rjopson/RoboAlt/README.md

# RoboAlt
Repository for hardware, firmware, test code for version 1 altimeter
