rjopson/RoboAlt/hardware/README.md

# Hardware

Current hardware:
+ Microcontroller - SAMD21G18A-AUT
+ Voltage Regulator - MIC5219-3.3BM5
+ Flash Memory - AT45DB641E
+ Output MOSFET's - DMN2008LFU
+ Speaker - 
+ Sensors:
  + Barometer, thermometer - MS5607
  + Accelerometer (low g) - MPU-6050
  + Accelerometer (high g) - H3LIS331DL
