rjopson/RoboAlt/hardware/KiCad/README.md

# KiCad Hardware Files

The Hardware folder contains all the KiCad hardware design files:
+ .pro is the project file - KiCad opens this
+ .sch is the schematic file
+ .kicad_pcb is the pcb board file. 
+ componentLibraries folder contains all the schematic and footprint components for the schematic and board files
