rjopson/RoboAlt/hardware/KiCad/BOM.xlsx

Sheet: Sheet1
version | source | date | tool | number | name | tstamps | title | company | rev | date2 | source3 | number4 | value | ref | value5 | footprint | lib | part | names | tstamps6 | tstamp | lib7 | part8 | field | name9 | num | name10 | type | description | fp | docs | logical | uri | code | name11 | ref12 | pin
D | C:/Users/Jim/Documents/Rockets/Altimeters/RoboDev/Hardware/KiCad/altimeter.sch | 7/25/2019 11:19:43 AM | Eeschema 4.0.4-stable | 1 | / | / | RoboAlt v0.1 |  | v0.1 | 2019-02-10 | altimeter.sch | 1
D | C:/Users/Jim/Documents/Rockets/Altimeters/RoboDev/Hardware/KiCad/altimeter.sch | 7/25/2019 11:19:43 AM | Eeschema 4.0.4-stable | 1 | / | / | RoboAlt v0.1 |  | v0.1 | 2019-02-10 | altimeter.sch | 2
D | C:/Users/Jim/Documents/Rockets/Altimeters/RoboDev/Hardware/KiCad/altimeter.sch | 7/25/2019 11:19:43 AM | Eeschema 4.0.4-stable | 1 | / | / | RoboAlt v0.1 |  | v0.1 | 2019-02-10 | altimeter.sch | 3
D | C:/Users/Jim/Documents/Rockets/Altimeters/RoboDev/Hardware/KiCad/altimeter.sch | 7/25/2019 11:19:43 AM | Eeschema 4.0.4-stable | 1 | / | / | RoboAlt v0.1 |  | v0.1 | 2019-02-10 | altimeter.sch | 4
D |  |  |  |  |  |  |  |  |  |  |  |  |  | U1 | SAMD21G18A-AUT | altimeterComponentFootprints:TQFP-48_7x7mm_Pitch0.5mm | altimeterComponentSchematics | SAMD21G18A-AUT | / | / | 5C610ED9
D |  |  |  |  |  |  |  |  |  |  |  |  |  | SP1 | SPEAKER | altimeterComponentFootprints:BUZZER_CCV | device | SPEAKER | / | / | 5C611002
D |  |  |  |  |  |  |  |  |  |  |  |  |  | U2 | MIC5219-3.3BM5 | altimeterComponentFootprints:SOT23_5 | altimeterComponentSchematics | MIC5219-3.3BM5 | / | / | 5C6110C4
D |  |  |  |  |  |  |  |  |  |  |  |  |  | C6 | 100mF | altimeterComponentFootprints:PB-5R0H104-R_Super_Capacitor_horizontal | device | CP | / | / | 5C61111F
D |  |  |  |  |  |  |  |  |  |  |  |  |  | U3 | MICRO-B_USB | altimeterComponentFootprints:USB-MICROB | altimeterComponentSchematics | MICRO-B_USB | / | / | 5C6111C9
D |  |  |  |  |  |  |  |  |  |  |  |  |  | U4 | H3LIS331DL | altimeterComponentFootprints:TFLGA-16 | altimeterComponentSchematics | H3LIS331DL | / | / | 5C611232
D |  |  |  |  |  |  |  |  |  |  |  |  |  | U6 | MS5607-02BA03 | altimeterComponentFootprints:QFN8_5x3mm | altimeterComponentSchematics | MS5607-02BA03 | / | / | 5C611291
D |  |  |  |  |  |  |  |  |  |  |  |  |  | U5 | MPU-6050 | altimeterComponentFootprints:QFN_24 | altimeterComponentSchematics | MPU-6050 | / | / | 5C6112D4
D |  |  |  |  |  |  |  |  |  |  |  |  |  | U7 | AT45DB641E | altimeterComponentFootprints:SO08_EIAJ | altimeterComponentSchematics | AT45DB641E | / | / | 5C61132F
D |  |  |  |  |  |  |  |  |  |  |  |  |  | SW1 | SPST | altimeterComponentFootprints:SWITCH_TACTILE_SPST | device | SPST | / | / | 5C611400
D |  |  |  |  |  |  |  |  |  |  |  |  |  | P1 | CONN_01X04 | altimeterComponentFootprints:SCREWTERMINAL_2.54mm_4 | conn | CONN_01X04 | / | / | 5C611553
D |  |  |  |  |  |  |  |  |  |  |  |  |  | P3 | CONN_01X01 | altimeterComponentFootprints:1pin | conn | CONN_01X01 | / | / | 5C61161C
D |  |  |  |  |  |  |  |  |  |  |  |  |  | P4 | CONN_01X01 | altimeterComponentFootprints:1pin | conn | CONN_01X01 | / | / | 5C611719
D |  |  |  |  |  |  |  |  |  |  |  |  |  | Q1 | DMN2008LFU | altimeterComponentFootprints:6-UFDFN_Exposed_Pad | altimeterComponentSchematics | DMN2008LFU | / | / | 5C6A396D
D |  |  |  |  |  |  |  |  |  |  |  |  |  | Q3 | DMN2008LFU | altimeterComponentFootprints:6-UFDFN_Exposed_Pad | altimeterComponentSchematics | DMN2008LFU | / | / | 5C6A4A38
D |  |  |  |  |  |  |  |  |  |  |  |  |  | Q4 | DMN2008LFU | altimeterComponentFootprints:6-UFDFN_Exposed_Pad | altimeterComponentSchematics | DMN2008LFU | / | / | 5C6A5DCD
D |  |  |  |  |  |  |  |  |  |  |  |  |  | P2 | CONN_01X04 | altimeterComponentFootprints:SCREWTERMINAL_2.54mm_4 | conn | CONN_01X04 | / | / | 5C6A6059
D |  |  |  |  |  |  |  |  |  |  |  |  |  | C9 | 2.2uF | altimeterComponentFootprints:C_0603 | device | C | / | / | 5C6A826D
D |  |  |  |  |  |  |  |  |  |  |  |  |  | D2 | LED | altimeterComponentFootprints:LED_0603 | device | LED | / | / | 5C6A82DE
D |  |  |  |  |  |  |  |  |  |  |  |  |  | R5 | 10 | altimeterComponentFootprints:R_1206 | device | R | / | / | 5C6A84CD
D |  |  |  |  |  |  |  |  |  |  |  |  |  | R6 | 4.7k | altimeterComponentFootprints:R_array_4x_1206 | altimeterComponentSchematics | R_4 | / | / | 5C6A8562
D |  |  |  |  |  |  |  |  |  |  |  |  |  | C11 | 10nF | altimeterComponentFootprints:C_0603 | device | C | / | / | 5C735557
D |  |  |  |  |  |  |  |  |  |  |  |  |  | C12 | 0.1uF | altimeterComponentFootprints:C_0603 | device | C | / | / | 5C735616
D |  |  |  |  |  |  |  |  |  |  |  |  |  | C15 | 0.1uF | altimeterComponentFootprints:C_0603 | device | C | / | / | 5C7356B4
D |  |  |  |  |  |  |  |  |  |  |  |  |  | C14 | 2.2nF | altimeterComponentFootprints:C_0603 | device | C | / | / | 5C73576D
D |  |  |  |  |  |  |  |  |  |  |  |  |  | C17 | 0.1uF | altimeterComponentFootprints:C_0603 | device | C | / | / | 5C73BE40
D |  |  |  |  |  |  |  |  |  |  |  |  |  | C16 | 10uF | altimeterComponentFootprints:C_0603 | device | C | / | / | 5C73BF1B
D |  |  |  |  |  |  |  |  |  |  |  |  |  | C13 | 0.1uF | altimeterComponentFootprints:C_0603 | device | C | / | / | 5C741175
D |  |  |  |  |  |  |  |  |  |  |  |  |  | Y1 | 32.768kHz | altimeterComponentFootprints:32khz_crystal | device | Crystal | / | / | 5C74A102
D |  |  |  |  |  |  |  |  |  |  |  |  |  | C3 | 12.5pF | altimeterComponentFootprints:C_array_2x_0805 | altimeterComponentSchematics | C_2 | / | / | 5C74A676
D |  |  |  |  |  |  |  |  |  |  |  |  |  | L1 | 10uH | altimeterComponentFootprints:C_0603 | altimeterComponentSchematics | L | / | / | 5C74BEBE
D |  |  |  |  |  |  |  |  |  |  |  |  |  | C4 | 0.1uF | altimeterComponentFootprints:C_0603 | device | C | / | / | 5C74C95B
D |  |  |  |  |  |  |  |  |  |  |  |  |  | C2 | 0.1uF | altimeterComponentFootprints:C_0603 | device | C | / | / | 5C7522E1
D |  |  |  |  |  |  |  |  |  |  |  |  |  | C8 | 0.1uF | altimeterComponentFootprints:C_0603 | device | C | / | / | 5C75AC96
D |  |  |  |  |  |  |  |  |  |  |  |  |  | C7 | 0.1uF | altimeterComponentFootprints:C_0603 | device | C | / | / | 5C75D376
D |  |  |  |  |  |  |  |  |  |  |  |  |  | C10 | 1uF | altimeterComponentFootprints:C_0603 | device | C | / | / | 5C75D432
D |  |  |  |  |  |  |  |  |  |  |  |  |  | C1 | 10uF | altimeterComponentFootprints:C_array_2x_0805 | altimeterComponentSchematics | C_2 | / | / | 5C75EA86
D |  |  |  |  |  |  |  |  |  |  |  |  |  | R4 | 330 | altimeterComponentFootprints:R_0603 | device | R | / | / | 5C762C04
D |  |  |  |  |  |  |  |  |  |  |  |  |  | C5 | 100pF | altimeterComponentFootprints:C_0603 | device | C | / | / | 5C762FD7
D |  |  |  |  |  |  |  |  |  |  |  |  |  | R3 | 27k | altimeterComponentFootprints:R_array_4x_1206 | altimeterComponentSchematics | R_4 | / | / | 5C769238
D |  |  |  |  |  |  |  |  |  |  |  |  |  | R2 | 100k | altimeterComponentFootprints:R_array_4x_1206 | altimeterComponentSchematics | R_4 | / | / | 5C76F35F
D |  |  |  |  |  |  |  |  |  |  |  |  |  | Q2 | DMN2008LFU | altimeterComponentFootprints:6-UFDFN_Exposed_Pad | altimeterComponentSchematics | DMN2008LFU | / | / | 5C778F61
D |  |  |  |  |  |  |  |  |  |  |  |  |  | R1 | 10k | altimeterComponentFootprints:R_array_4x_1206 | altimeterComponentSchematics | R_4 | / | / | 5C77A1B0
D |  |  |  |  |  |  |  |  |  |  |  |  |  | D1 | Schottky_3 | altimeterComponentFootprints:SOT363 | altimeterComponentSchematics | Schottky_3 | / | / | 5C78129E
D |  |  |  |  |  |  |  |  |  |  |  |  |  |  |  |  |  |  |  |  |  | altimeterComponentSchematics | AT45DB641E | U | Reference
D |  |  |  |  |  |  |  |  |  |  |  |  |  |  |  |  |  |  |  |  |  | altimeterComponentSchematics | AT45DB641E | AT45DB641E | Value
D |  |  |  |  |  |  |  |  |  |  |  |  |  |  |  |  |  |  |  |  |  | altimeterComponentSchematics | AT45DB641E |  |  | 1 | SI | passive
D |  |  |  |  |  |  |  |  |  |  |  |  |  |  |  |  |  |  |  |  |  | altimeterComponentSchematics | AT45DB641E |  |  | 2 | SCK | passive
D |  |  |  |  |  |  |  |  |  |  |  |  |  |  |  |  |  |  |  |  |  | altimeterComponentSchematics | AT45DB641E |  |  | 3 | RESET | passive
D |  |  |  |  |  |  |  |  |  |  |  |  |  |  |  |  |  |  |  |  |  | altimeterComponentSchematics | AT45DB641E |  |  | 4 | CS | passive
D |  |  |  |  |  |  |  |  |  |  |  |  |  |  |  |  |  |  |  |  |  | altimeterComponentSchematics | AT45DB641E |  |  | 5 | WP | passive
D |  |  |  |  |  |  |  |  |  |  |  |  |  |  |  |  |  |  |  |  |  | altimeterComponentSchematics | AT45DB641E |  |  | 6 | VCC | passive
D |  |  |  |  |  |  |  |  |  |  |  |  |  |  |  |  |  |  |  |  |  | altimeterComponentSchematics | AT45DB641E |  |  | 7 | GND | passive
D |  |  |  |  |  |  |  |  |  |  |  |  |  |  |  |  |  |  |  |  |  | altimeterComponentSchematics | AT45DB641E |  |  | 8 | SO | passive
D |  |  |  |  |  |  |  |  |  |  |  |  |  |  |  |  |  |  |  |  |  | device | C | C | Reference |  |  |  | Unpolarized capacitor
D |  |  |  |  |  |  |  |  |  |  |  |  |  |  |  |  |  |  |  |  |  | device | C | C | Value |  |  |  | Unpolarized capacitor
D |  |  |  |  |  |  |  |  |  |  |  |  |  |  |  |  |  |  |  |  |  | device | C |  |  | 1 | ~ | passive | Unpolarized capacitor
D |  |  |  |  |  |  |  |  |  |  |  |  |  |  |  |  |  |  |  |  |  | device | C |  |  | 2 | ~ | passive | Unpolarized capacitor
D |  |  |  |  |  |  |  |  |  |  |  |  |  |  |  |  |  |  |  |  |  | device | C |  |  |  |  |  | Unpolarized capacitor | C?
D |  |  |  |  |  |  |  |  |  |  |  |  |  |  |  |  |  |  |  |  |  | device | C |  |  |  |  |  | Unpolarized capacitor | C_????_*
D |  |  |  |  |  |  |  |  |  |  |  |  |  |  |  |  |  |  |  |  |  | device | C |  |  |  |  |  | Unpolarized capacitor | C_????
D |  |  |  |  |  |  |  |  |  |  |  |  |  |  |  |  |  |  |  |  |  | device | C |  |  |  |  |  | Unpolarized capacitor | SMD*_c
D |  |  |  |  |  |  |  |  |  |  |  |  |  |  |  |  |  |  |  |  |  | device | C |  |  |  |  |  | Unpolarized capacitor | Capacitor*
D |  |  |  |  |  |  |  |  |  |  |  |  |  |  |  |  |  |  |  |  |  | conn | CONN_01X01 | P | Reference |  |  |  | Connector, single row, 01x01
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
D |  |  |  |  |  |  |  |  |  |  |  |  |  |  |  |  |  |  |  |  |  | altimeterComponentSchematics | C_2 |  |  | 2 | ~ | passive
D |  |  |  |  |  |  |  |  |  |  |  |  |  |  |  |  |  |  |  |  |  | altimeterComponentSchematics | C_2 |  |  | 3 | ~ | passive
D |  |  |  |  |  |  |  |  |  |  |  |  |  |  |  |  |  |  |  |  |  | altimeterComponentSchematics | C_2 |  |  | 4 | ~ | passive
D |  |  |  |  |  |  |  |  |  |  |  |  |  |  |  |  |  |  |  |  |  | altimeterComponentSchematics | C_2 |  |  |  |  |  |  | C?
D |  |  |  |  |  |  |  |  |  |  |  |  |  |  |  |  |  |  |  |  |  | altimeterComponentSchematics | C_2 |  |  |  |  |  |  | C_????_*
D |  |  |  |  |  |  |  |  |  |  |  |  |  |  |  |  |  |  |  |  |  | altimeterComponentSchematics | C_2 |  |  |  |  |  |  | C_????
D |  |  |  |  |  |  |  |  |  |  |  |  |  |  |  |  |  |  |  |  |  | altimeterComponentSchematics | C_2 |  |  |  |  |  |  | SMD*_c
D |  |  |  |  |  |  |  |  |  |  |  |  |  |  |  |  |  |  |  |  |  | altimeterComponentSchematics | C_2 |  |  |  |  |  |  | Capacitor*
D |  |  |  |  |  |  |  |  |  |  |  |  |  |  |  |  |  |  |  |  |  | device | Crystal | Y | Reference |  |  |  | Two pin crystal
D |  |  |  |  |  |  |  |  |  |  |  |  |  |  |  |  |  |  |  |  |  | device | Crystal | Crystal | Value |  |  |  | Two pin crystal
D |  |  |  |  |  |  |  |  |  |  |  |  |  |  |  |  |  |  |  |  |  | device | Crystal |  |  | 1 | 1 | passive | Two pin crystal
D |  |  |  |  |  |  |  |  |  |  |  |  |  |  |  |  |  |  |  |  |  | device | Crystal |  |  | 2 | 2 | passive | Two pin crystal
D |  |  |  |  |  |  |  |  |  |  |  |  |  |  |  |  |  |  |  |  |  | device | Crystal |  |  |  |  |  | Two pin crystal | Crystal_*
D |  |  |  |  |  |  |  |  |  |  |  |  |  |  |  |  |  |  |  |  |  | altimeterComponentSchematics | DMN2008LFU | Q | Reference |  |  |  | 60V Vds 0.5A Id, N-Channel MOSFET, SOT-23 |  | http://www.fairchildsemi.com/ds/BS/BS170.pdf
D |  |  |  |  |  |  |  |  |  |  |  |  |  |  |  |  |  |  |  |  |  | altimeterComponentSchematics | DMN2008LFU | DMN2008LFU | Value |  |  |  | 60V Vds 0.5A Id, N-Channel MOSFET, SOT-23 |  | http://www.fairchildsemi.com/ds/BS/BS170.pdf
D |  |  |  |  |  |  |  |  |  |  |  |  |  |  |  |  |  |  |  |  |  | altimeterComponentSchematics | DMN2008LFU | 4 pin | Footprint |  |  |  | 60V Vds 0.5A Id, N-Channel MOSFET, SOT-23 |  | http://www.fairchildsemi.com/ds/BS/BS170.pdf
D |  |  |  |  |  |  |  |  |  |  |  |  |  |  |  |  |  |  |  |  |  | altimeterComponentSchematics | DMN2008LFU |  |  | 1 | G | input | 60V Vds 0.5A Id, N-Channel MOSFET, SOT-23 |  | http://www.fairchildsemi.com/ds/BS/BS170.pdf
D |  |  |  |  |  |  |  |  |  |  |  |  |  |  |  |  |  |  |  |  |  | altimeterComponentSchematics | DMN2008LFU |  |  | 2 | S | passive | 60V Vds 0.5A Id, N-Channel MOSFET, SOT-23 |  | http://www.fairchildsemi.com/ds/BS/BS170.pdf
D |  |  |  |  |  |  |  |  |  |  |  |  |  |  |  |  |  |  |  |  |  | altimeterComponentSchematics | DMN2008LFU |  |  | 3 | D | passive | 60V Vds 0.5A Id, N-Channel MOSFET, SOT-23 |  | http://www.fairchildsemi.com/ds/BS/BS170.pdf
D |  |  |  |  |  |  |  |  |  |  |  |  |  |  |  |  |  |  |  |  |  | altimeterComponentSchematics | DMN2008LFU |  |  |  |  |  | 60V Vds 0.5A Id, N-Channel MOSFET, SOT-23 | SOT-23* | http://www.fairchildsemi.com/ds/BS/BS170.pdf
D |  |  |  |  |  |  |  |  |  |  |  |  |  |  |  |  |  |  |  |  |  | altimeterComponentSchematics | H3LIS331DL | U | Reference
D |  |  |  |  |  |  |  |  |  |  |  |  |  |  |  |  |  |  |  |  |  | altimeterComponentSchematics | H3LIS331DL | H3LIS331DL | Value
D |  |  |  |  |  |  |  |  |  |  |  |  |  |  |  |  |  |  |  |  |  | altimeterComponentSchematics | H3LIS331DL |  |  | 1 | VDD_IO | passive
D |  |  |  |  |  |  |  |  |  |  |  |  |  |  |  |  |  |  |  |  |  | altimeterComponentSchematics | H3LIS331DL |  |  | 2 | NC | passive
D |  |  |  |  |  |  |  |  |  |  |  |  |  |  |  |  |  |  |  |  |  | altimeterComponentSchematics | H3LIS331DL |  |  | 3 | NC | passive
D |  |  |  |  |  |  |  |  |  |  |  |  |  |  |  |  |  |  |  |  |  | altimeterComponentSchematics | H3LIS331DL |  |  | 4 | SCL/SPC | passive
D |  |  |  |  |  |  |  |  |  |  |  |  |  |  |  |  |  |  |  |  |  | altimeterComponentSchematics | H3LIS331DL |  |  | 5 | GND | passive
D |  |  |  |  |  |  |  |  |  |  |  |  |  |  |  |  |  |  |  |  |  | altimeterComponentSchematics | H3LIS331DL |  |  | 6 | SDA/SDI/SDO | passive
D |  |  |  |  |  |  |  |  |  |  |  |  |  |  |  |  |  |  |  |  |  | altimeterComponentSchematics | H3LIS331DL |  |  | 7 | SDO/SDA0 | passive
D |  |  |  |  |  |  |  |  |  |  |  |  |  |  |  |  |  |  |  |  |  | altimeterComponentSchematics | H3LIS331DL |  |  | 8 | CS | passive
D |  |  |  |  |  |  |  |  |  |  |  |  |  |  |  |  |  |  |  |  |  | altimeterComponentSchematics | H3LIS331DL |  |  | 9 | INT2 | passive
D |  |  |  |  |  |  |  |  |  |  |  |  |  |  |  |  |  |  |  |  |  | altimeterComponentSchematics | H3LIS331DL |  |  | 10 | RESERVED | passive
D |  |  |  |  |  |  |  |  |  |  |  |  |  |  |  |  |  |  |  |  |  | altimeterComponentSchematics | H3LIS331DL |  |  | 11 | INT1 | passive
D |  |  |  |  |  |  |  |  |  |  |  |  |  |  |  |  |  |  |  |  |  | altimeterComponentSchematics | H3LIS331DL |  |  | 12 | GND | passive
D |  |  |  |  |  |  |  |  |  |  |  |  |  |  |  |  |  |  |  |  |  | altimeterComponentSchematics | H3LIS331DL |  |  | 13 | GND | passive
D |  |  |  |  |  |  |  |  |  |  |  |  |  |  |  |  |  |  |  |  |  | altimeterComponentSchematics | H3LIS331DL |  |  | 14 | VDD | passive
D |  |  |  |  |  |  |  |  |  |  |  |  |  |  |  |  |  |  |  |  |  | altimeterComponentSchematics | H3LIS331DL |  |  | 15 | RESERVED | passive
D |  |  |  |  |  |  |  |  |  |  |  |  |  |  |  |  |  |  |  |  |  | altimeterComponentSchematics | H3LIS331DL |  |  | 16 | GND | passive
D |  |  |  |  |  |  |  |  |  |  |  |  |  |  |  |  |  |  |  |  |  | altimeterComponentSchematics | L | L | Reference |  |  |  | Inductor
D |  |  |  |  |  |  |  |  |  |  |  |  |  |  |  |  |  |  |  |  |  | altimeterComponentSchematics | L | L | Value |  |  |  | Inductor
D |  |  |  |  |  |  |  |  |  |  |  |  |  |  |  |  |  |  |  |  |  | altimeterComponentSchematics | L |  |  | 1 | ~ | passive | Inductor
D |  |  |  |  |  |  |  |  |  |  |  |  |  |  |  |  |  |  |  |  |  | altimeterComponentSchematics | L |  |  | 2 | ~ | passive | Inductor
D |  |  |  |  |  |  |  |  |  |  |  |  |  |  |  |  |  |  |  |  |  | altimeterComponentSchematics | L |  |  |  |  |  | Inductor | Choke_*
D |  |  |  |  |  |  |  |  |  |  |  |  |  |  |  |  |  |  |  |  |  | altimeterComponentSchematics | L |  |  |  |  |  | Inductor | *Coil*
D |  |  |  |  |  |  |  |  |  |  |  |  |  |  |  |  |  |  |  |  |  | device | LED | D | Reference
D |  |  |  |  |  |  |  |  |  |  |  |  |  |  |  |  |  |  |  |  |  | device | LED | LED | Value
D |  |  |  |  |  |  |  |  |  |  |  |  |  |  |  |  |  |  |  |  |  | device | LED |  |  | 1 | K | passive
D |  |  |  |  |  |  |  |  |  |  |  |  |  |  |  |  |  |  |  |  |  | device | LED |  |  | 2 | A | passive
D |  |  |  |  |  |  |  |  |  |  |  |  |  |  |  |  |  |  |  |  |  | device | LED |  |  |  |  |  |  | LED-*
D |  |  |  |  |  |  |  |  |  |  |  |  |  |  |  |  |  |  |  |  |  | device | LED |  |  |  |  |  |  | LED_*
D |  |  |  |  |  |  |  |  |  |  |  |  |  |  |  |  |  |  |  |  |  | altimeterComponentSchematics | MIC5219-3.3BM5 | U | Reference
D |  |  |  |  |  |  |  |  |  |  |  |  |  |  |  |  |  |  |  |  |  | altimeterComponentSchematics | MIC5219-3.3BM5 | MIC5219-3.3BM5 | Value
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
D |  |  |  |  |  |  |  |  |  |  |  |  |  |  |  |  |  |  |  |  |  | altimeterComponentSchematics | SAMD21G18A-AUT |  |  | 46 | PA31/EIC/SCOM1PAD3/TC | input
D |  |  |  |  |  |  |  |  |  |  |  |  |  |  |  |  |  |  |  |  |  | altimeterComponentSchematics | SAMD21G18A-AUT |  |  | 47 | PB02/EIC/AIN10/SCOM5PAD0 | input
D |  |  |  |  |  |  |  |  |  |  |  |  |  |  |  |  |  |  |  |  |  | altimeterComponentSchematics | SAMD21G18A-AUT |  |  | 48 | PB03/EIC/AIN11/SCOM5PAD1 | input
D |  |  |  |  |  |  |  |  |  |  |  |  |  |  |  |  |  |  |  |  |  | device | SPEAKER | SP | Reference |  |  |  | Audio speaker, 2 pins, generic symbol
D |  |  |  |  |  |  |  |  |  |  |  |  |  |  |  |  |  |  |  |  |  | device | SPEAKER | SPEAKER | Value |  |  |  | Audio speaker, 2 pins, generic symbol
D |  |  |  |  |  |  |  |  |  |  |  |  |  |  |  |  |  |  |  |  |  | device | SPEAKER |  |  | 1 | 1 | input | Audio speaker, 2 pins, generic symbol
D |  |  |  |  |  |  |  |  |  |  |  |  |  |  |  |  |  |  |  |  |  | device | SPEAKER |  |  | 2 | 2 | input | Audio speaker, 2 pins, generic symbol
D |  |  |  |  |  |  |  |  |  |  |  |  |  |  |  |  |  |  |  |  |  | device | SPST | SW | Reference |  |  |  | Interrupteur simple
D |  |  |  |  |  |  |  |  |  |  |  |  |  |  |  |  |  |  |  |  |  | device | SPST | SPST | Value |  |  |  | Interrupteur simple
D |  |  |  |  |  |  |  |  |  |  |  |  |  |  |  |  |  |  |  |  |  | device | SPST |  |  | 1 | 1 | input | Interrupteur simple
D |  |  |  |  |  |  |  |  |  |  |  |  |  |  |  |  |  |  |  |  |  | device | SPST |  |  | 2 | 2 | input | Interrupteur simple
D |  |  |  |  |  |  |  |  |  |  |  |  |  |  |  |  |  |  |  |  |  | altimeterComponentSchematics | Schottky_3 | D | Reference
D |  |  |  |  |  |  |  |  |  |  |  |  |  |  |  |  |  |  |  |  |  | altimeterComponentSchematics | Schottky_3 | Schottky_3 | Value
D |  |  |  |  |  |  |  |  |  |  |  |  |  |  |  |  |  |  |  |  |  | altimeterComponentSchematics | Schottky_3 |  |  | 1 | K | passive
D |  |  |  |  |  |  |  |  |  |  |  |  |  |  |  |  |  |  |  |  |  | altimeterComponentSchematics | Schottky_3 |  |  | 2 | A | passive
D |  |  |  |  |  |  |  |  |  |  |  |  |  |  |  |  |  |  |  |  |  | altimeterComponentSchematics | Schottky_3 |  |  | 3 | K | passive
D |  |  |  |  |  |  |  |  |  |  |  |  |  |  |  |  |  |  |  |  |  | altimeterComponentSchematics | Schottky_3 |  |  | 4 | A | passive
D |  |  |  |  |  |  |  |  |  |  |  |  |  |  |  |  |  |  |  |  |  | altimeterComponentSchematics | Schottky_3 |  |  | 5 | K | passive
D |  |  |  |  |  |  |  |  |  |  |  |  |  |  |  |  |  |  |  |  |  | altimeterComponentSchematics | Schottky_3 |  |  | 6 | A | passive
D |  |  |  |  |  |  |  |  |  |  |  |  |  |  |  |  |  |  |  |  |  | altimeterComponentSchematics | Schottky_3 |  |  |  |  |  |  | D-Pak_TO252AA
D |  |  |  |  |  |  |  |  |  |  |  |  |  |  |  |  |  |  |  |  |  | altimeterComponentSchematics | Schottky_3 |  |  |  |  |  |  | Diode_*
D |  |  |  |  |  |  |  |  |  |  |  |  |  |  |  |  |  |  |  |  |  | altimeterComponentSchematics | Schottky_3 |  |  |  |  |  |  | *SingleDiode
D |  |  |  |  |  |  |  |  |  |  |  |  |  |  |  |  |  |  |  |  |  | altimeterComponentSchematics | Schottky_3 |  |  |  |  |  |  | *SingleDiode*
D |  |  |  |  |  |  |  |  |  |  |  |  |  |  |  |  |  |  |  |  |  | altimeterComponentSchematics | Schottky_3 |  |  |  |  |  |  | *_Diode_*
D |  |  |  |  |  |  |  |  |  |  |  |  |  |  |  |  |  |  |  |  |  |  |  |  |  |  |  |  |  |  |  | device | C:\Program Files\KiCad\share\kicad\library\device.lib
D |  |  |  |  |  |  |  |  |  |  |  |  |  |  |  |  |  |  |  |  |  |  |  |  |  |  |  |  |  |  |  | conn | C:\Program Files\KiCad\share\kicad\library\conn.lib
D |  |  |  |  |  |  |  |  |  |  |  |  |  |  |  |  |  |  |  |  |  |  |  |  |  |  |  |  |  |  |  | altimeterComponentSchematics | C:\Users\Jim\Documents\Rockets\Altimeters\RoboDev\Hardware\KiCad\componentLibraries\altimeterComponentSchematics.lib
D |  |  |  |  |  |  |  |  |  |  |  |  |  |  |  |  |  |  |  |  |  |  |  |  |  |  |  |  |  |  |  |  |  | 1 | Net-(U1-Pad3) | U1 | 3
D |  |  |  |  |  |  |  |  |  |  |  |  |  |  |  |  |  |  |  |  |  |  |  |  |  |  |  |  |  |  |  |  |  | 2 | Net-(U1-Pad4) | U1 | 4
D |  |  |  |  |  |  |  |  |  |  |  |  |  |  |  |  |  |  |  |  |  |  |  |  |  |  |  |  |  |  |  |  |  | 3 | GND | U5 | 11
D |  |  |  |  |  |  |  |  |  |  |  |  |  |  |  |  |  |  |  |  |  |  |  |  |  |  |  |  |  |  |  |  |  | 3 | GND | U7 | 7
D |  |  |  |  |  |  |  |  |  |  |  |  |  |  |  |  |  |  |  |  |  |  |  |  |  |  |  |  |  |  |  |  |  | 3 | GND | U5 | 18
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
D |  |  |  |  |  |  |  |  |  |  |  |  |  |  |  |  |  |  |  |  |  |  |  |  |  |  |  |  |  |  |  |  |  | 79 | /MAIN | R2 | 3
D |  |  |  |  |  |  |  |  |  |  |  |  |  |  |  |  |  |  |  |  |  |  |  |  |  |  |  |  |  |  |  |  |  | 79 | /MAIN | Q4 | 3

Sheet: Sheet2
value | component | footprint
C1 | 10uF | altimeterComponentFootprints:C_array_2x_0805
C10 | 1uF | altimeterComponentFootprints:C_0603
C11 | 10nF | altimeterComponentFootprints:C_0603
C12 | 0.1uF | altimeterComponentFootprints:C_0603
C13 | 0.1uF | altimeterComponentFootprints:C_0603
C14 | 2.2nF | altimeterComponentFootprints:C_0603
C15 | 0.1uF | altimeterComponentFootprints:C_0603
C16 | 10uF | altimeterComponentFootprints:C_0603
C17 | 0.1uF | altimeterComponentFootprints:C_0603
C2 | 0.1uF | altimeterComponentFootprints:C_0603
C3 | 15pF | altimeterComponentFootprints:C_array_2x_0805
C4 | 0.1uF | altimeterComponentFootprints:C_0603
C5 | 100pF | altimeterComponentFootprints:C_0603
C6 | 100mF | altimeterComponentFootprints:PB-5R0H104-R_Super_Capacitor_horizontal
C7 | 0.1uF | altimeterComponentFootprints:C_0603
C8 | 0.1uF | altimeterComponentFootprints:C_0603
C9 | 2.2uF | altimeterComponentFootprints:C_0603
D1 | Schottky_3 | altimeterComponentFootprints:SOT363
D2 | LED | altimeterComponentFootprints:LED_0603
L1 | 10uH | altimeterComponentFootprints:C_0603
P1 | CONN_01X04 | altimeterComponentFootprints:SCREWTERMINAL_2.54mm_4
P2 | CONN_01X04 | altimeterComponentFootprints:SCREWTERMINAL_2.54mm_4
P3 | CONN_01X01 | altimeterComponentFootprints:1pin
P4 | CONN_01X01 | altimeterComponentFootprints:1pin
Q1 | DMN2008LFU | altimeterComponentFootprints:6-UFDFN_Exposed_Pad
Q2 | DMN2008LFU | altimeterComponentFootprints:6-UFDFN_Exposed_Pad
Q3 | DMN2008LFU | altimeterComponentFootprints:6-UFDFN_Exposed_Pad
Q4 | DMN2008LFU | altimeterComponentFootprints:6-UFDFN_Exposed_Pad
R1 | 10k | altimeterComponentFootprints:R_array_4x_1206
R2 | 100k | altimeterComponentFootprints:R_array_4x_1206
R3 | 27k | altimeterComponentFootprints:R_array_4x_1206
R4 | 330 | altimeterComponentFootprints:R_0603
R5 | 10 | altimeterComponentFootprints:R_1206
R6 | 4.7k | altimeterComponentFootprints:R_array_4x_1206
SP1 | SPEAKER | altimeterComponentFootprints:BUZZER_CCV
SW1 | SPST | altimeterComponentFootprints:SWITCH_TACTILE_SPST
U1 | SAMD21G18A-AUT | altimeterComponentFootprints:TQFP-48_7x7mm_Pitch0.5mm
U2 | MIC5219-3.3BM5 | altimeterComponentFootprints:SOT23_5
U3 | MICRO-B_USB | altimeterComponentFootprints:USB-MICROB
U4 | H3LIS331DL | altimeterComponentFootprints:TFLGA-16
U5 | MPU-6050 | altimeterComponentFootprints:QFN_24
U6 | MS5607-02BA03 | altimeterComponentFootprints:QFN8_5x3mm
U7 | AT45DB641E | altimeterComponentFootprints:SO08_EIAJ
Y1 | 32.768kHz | altimeterComponentFootprints:32khz_crystal
