rjopson/RoboAlt/firmware/tests/integration/Output/processData_output.csv

*VERSION | 0.2
*PAD_MPU | 2024
*PAD_H3LIS | 60
*PAD_PRESSURE | 6315449
*PAD_TEMPERATURE | 8753148
*CALIBRATION_MS5607 | 42640 | 40615 | 26575 | 24961 | 31880 | 28219
*PAD_VOLTAGE | 0
*APO_EVENT | 3
*APO_DELAY | 0
*MAIN_EVENT | 4
*MAIN_DELAY | 0
*3RD_EVENT | 3
*3RD_DELAY | 500
*ALTITUDE_MAIN | 500000
*DATA | 2762
263355 | 0 | 0 | 0 | 224 | -935 | 450 | 98623 | 3978 | 126 | 2035 | -220 | -61 | 33 | -12 | 80 | 6316512 | 8749536 | 289 | 288 | 284 | 9
263369 | 0 | 0 | 3 | 325 | -935 | 392 | 98623 | 3978 | 117 | 2023 | -207 | -53 | 27 | -10 | 80 | 6316512 | 8749536 | 290 | 287 | 285 | 9
263382 | 0 | 0 | 8 | 451 | 595 | 531 | 98605 | 3980 | 87 | 2052 | -223 | -65 | 32 | -10 | 48 | 6316000 | 8750048 | 290 | 287 | 284 | 9
263394 | 0 | 0 | 14 | 512 | -1275 | 550 | 98627 | 3980 | 94 | 2056 | -214 | -64 | 35 | -15 | 48 | 6316512 | 8750048 | 290 | 287 | 285 | 9
263413 | 0 | 0 | 23 | 426 | -935 | 373 | 98623 | 3978 | 111 | 2019 | -195 | -64 | 30 | -15 | 0 | 6316512 | 8749536 | 290 | 287 | 285 | 10
263427 | 0 | 0 | 29 | 414 | -935 | 407 | 98623 | 3978 | 114 | 2026 | -219 | -76 | 34 | -11 | 32 | 6316512 | 8749536 | 290 | 287 | 285 | 10
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
