rjopson/RoboAlt/flight_tests/3DPME_24mm_E9-8_TriCities_9-2019_v2.csv

*VERSION | 0.2
*PAD_MPU | -2094
*PAD_H3LIS | -257
*PAD_PRESSURE | 6298379
*PAD_TEMPERATURE | 9424352
*CALIBRATION_MS5607 | 43232 | 41426 | 26917 | 25952 | 34097 | 27853
*PAD_VOLTAGE | 4100
*APO_EVENT | 3
*APO_DELAY | 0
*MAIN_EVENT | 4
*MAIN_DELAY | 0
*3RD_EVENT | 3
*3RD_DELAY | 500
*ALTITUDE_MAIN | 500000
*DATA | 1068
841370 | 0 | -51 | -23 | 72 | -765 | 72 | 98780 | 4309 | 162 | -2106 | -250 | -17 | 21 | -33 | -272 | 6298592 | 9424352 | 278 | 6 | 5 | 6
841388 | 0 | -29 | -8 | 72 | 1359 | 72 | 98755 | 4307 | 113 | -2106 | -257 | -14 | 8 | -31 | -240 | 6298080 | 9423840 | 277 | 6 | 5 | 6
841401 | 0 | -41 | -14 | 75 | -765 | 77 | 98780 | 4309 | 138 | -2110 | -269 | -17 | 14 | -30 | -240 | 6298592 | 9424352 | 278 | 6 | 5 | 6
841414 | 0 | -22 | -2 | 61 | 1104 | 53 | 98758 | 4309 | 155 | -2105 | -255 | -15 | 7 | -31 | -240 | 6298080 | 9424352 | 277 | 5 | 5 | 5
841427 | 0 | -34 | -9 | 17 | -765 | -9 | 98780 | 4309 | 158 | -2092 | -256 | -15 | 11 | -28 | -272 | 6298592 | 9424352 | 277 | 6 | 4 | 4
841445 | 0 | -46 | -16 | 4 | -765 | -4 | 98780 | 4309 | 150 | -2093 | -235 | -15 | 12 | -30 | -272 | 6298592 | 9424352 | 277 | 6 | 5 | 5
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
