rjopson/RoboAlt/flight_tests/3DPME_29mm_H128_TriCities_9-2019.csv

*VERSION 0.1
*PAD_MPU 1938
*PAD_H3LIS 47
*PAD_PRESSURE 6315344
*PAD_TEMPERATURE 8754820 | 0 | 42640 | 40615 | 26575 | 24961 | 31880 | 28219 | 2762 | 50000 | 3 | 4 | 3 | 0 | 0 | 500
263336 | 0 | 715 | 271 | 64 | -765 | 81 | 98623 | 3978 | 106 | 2041 | -228 | -63 | 33 | -11 | 32 | 6316512 | 8749536 | 291 | 287 | 285 | 10
263355 | 0 | 696 | 258 | 56 | -765 | 52 | 98623 | 3978 | 126 | 2035 | -220 | -61 | 33 | -12 | 80 | 6316512 | 8749536 | 289 | 288 | 284 | 9
263369 | 0 | 675 | 245 | 18 | -765 | -5 | 98623 | 3978 | 117 | 2023 | -207 | -53 | 27 | -10 | 80 | 6316512 | 8749536 | 290 | 288 | 284 | 9
263382 | 0 | 680 | 246 | 89 | 765 | 134 | 98605 | 3980 | 87 | 2052 | -223 | -65 | 32 | -10 | 48 | 6316000 | 8750048 | 290 | 287 | 285 | 9
263394 | 0 | 653 | 230 | 128 | -1105 | 153 | 98627 | 3980 | 94 | 2056 | -214 | -64 | 35 | -15 | 48 | 6316512 | 8750048 | 290 | 287 | 284 | 9
263413 | 0 | 634 | 218 | 34 | -765 | -24 | 98623 | 3978 | 111 | 2019 | -195 | -64 | 30 | -15 | 0 | 6316512 | 8749536 | 290 | 287 | 285 | 9
263427 | 0 | 614 | 205 | 18 | -765 | 9 | 98623 | 3978 | 114 | 2026 | -219 | -76 | 34 | -11 | 32 | 6316512 | 8749536 | 290 | 287 | 285 | 10
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
