rjopson/RoboAlt/TODO.md

Simulation
-staging
-clusters
-wind+pitch
-GUI
+rocket design drawing
+2d plotting
+parts creation
+tree
+property table
-simulation engine - speed up sim on descent
-drag for different NC profiles
-angle during ascent
-units 

-tilt angle post processing
-flight motor post processing

Firmware
-tilt angle calculation

Hardware
