rjopson/RoboAlt/(list of files, drawings)

Other design files:
hardware/KiCad/altimeter.dsn
