rjopson/RoboAlt/hardware/KiCad/altimeter.kicad_pcb

## KiCad design hardware/KiCad/altimeter.kicad_pcb (2019-09-04)

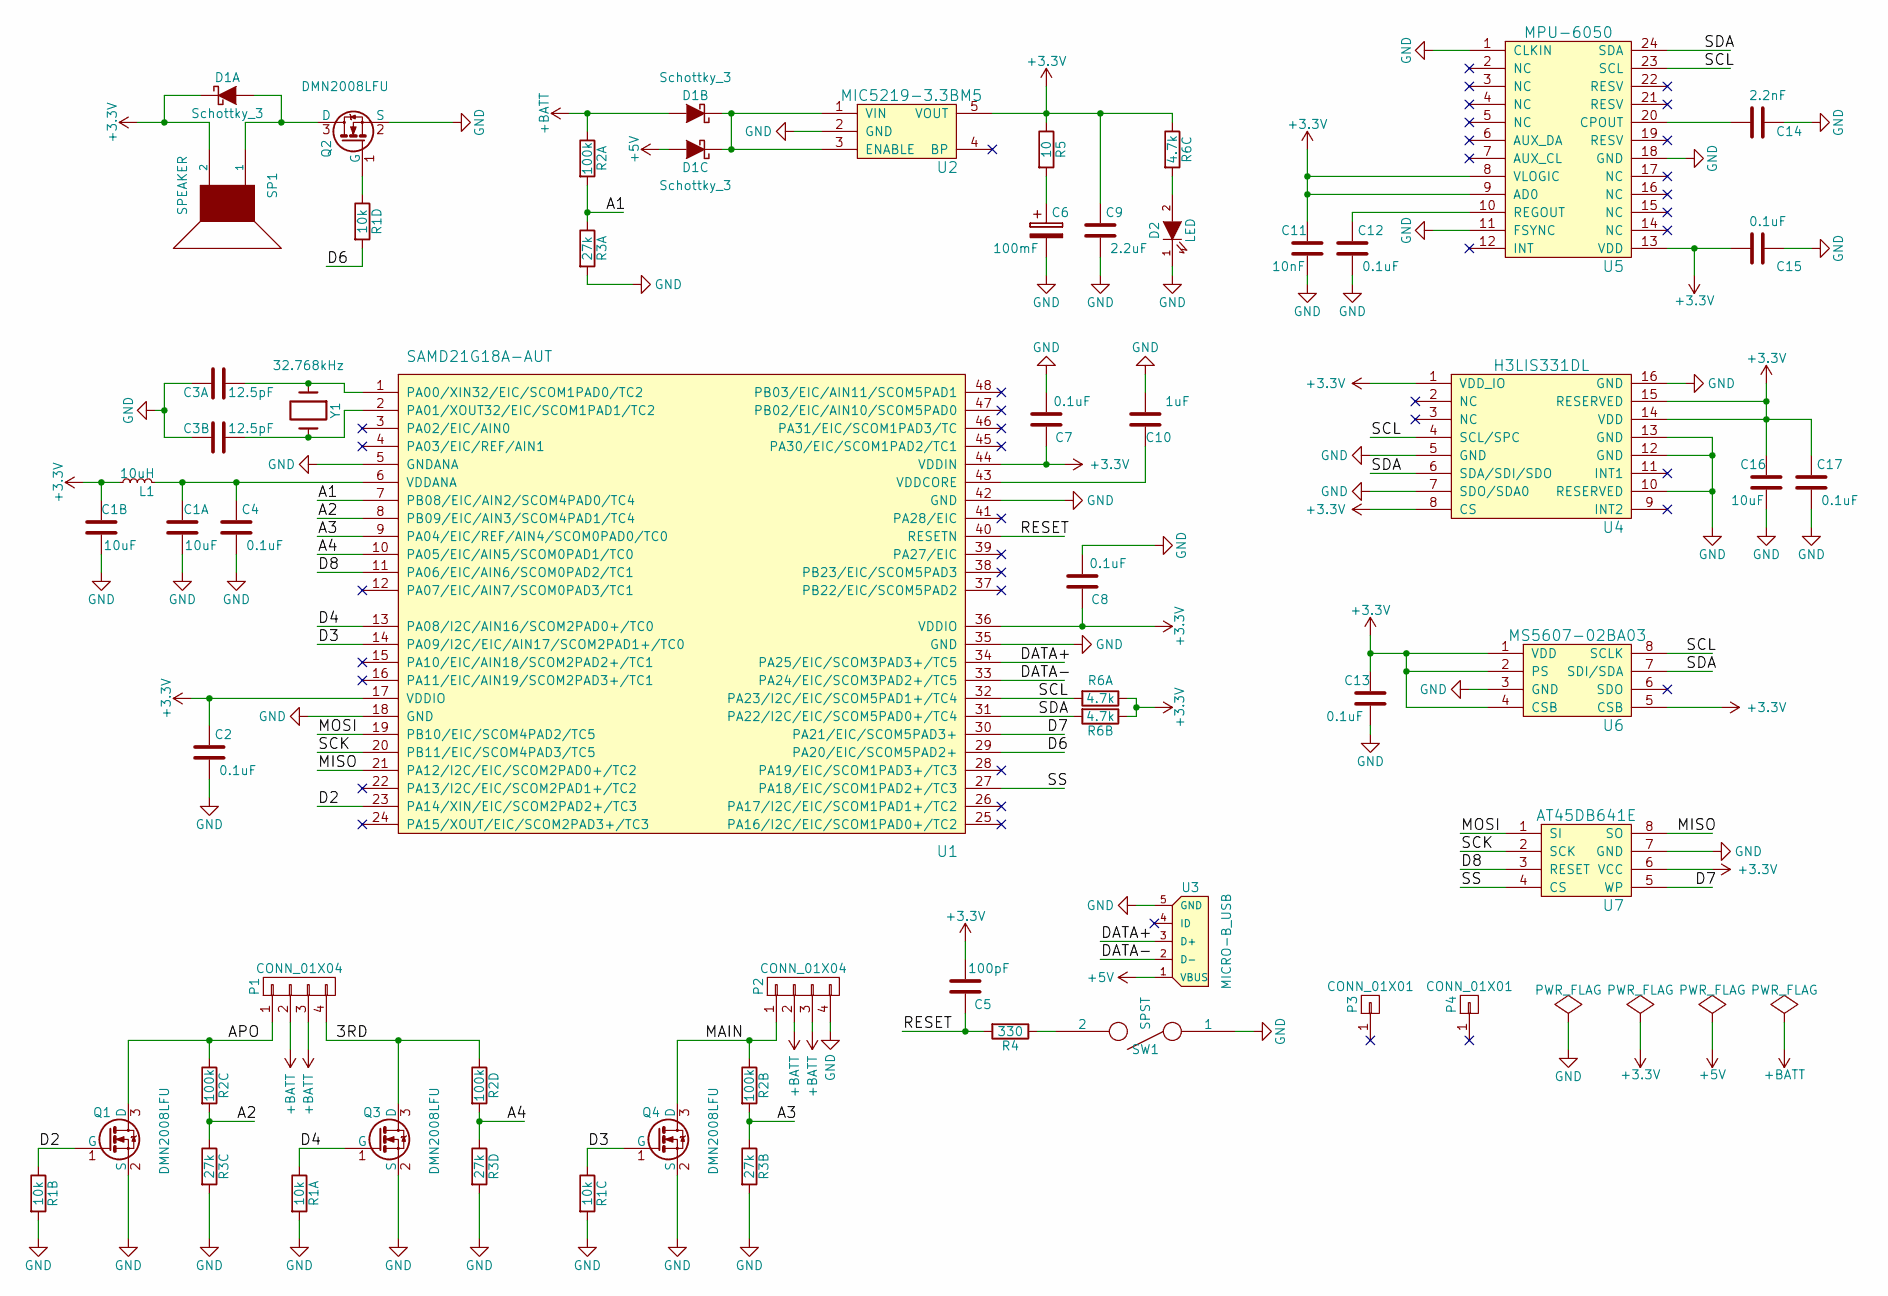
[picture p1: schematic altimeter.sch, RoboAlt v0.1]

Parts:
C1: 10uF; C_array_2x_0805
C2, C4, C7, C8, C12, C13, C15, C17: 0.1uF; C_0603
C3: 12.5pF; C_array_2x_0805
C5: 100pF; C_0603
C6: 100mF; PB-5R0H104-R_Super_Capacitor_horizontal
C9: 2.2uF; C_0603
C10: 1uF; C_0603
C11: 10nF; C_0603
C14: 2.2nF; C_0603
C16: 10uF; C_0603
D1: Schottky_3; SOT363
D2: LED; LED_0603
L1: 10uH; C_0603
P1, P2: CONN_01X04; SCREWTERMINAL_2.54mm_4
P3, P4: CONN_01X01; 1pin
Q1, Q2, Q3, Q4: DMN2008LFU; 6-UFDFN_Exposed_Pad
R1: 10k; R_array_4x_1206
R2: 100k; R_array_4x_1206
R3: 27k; R_array_4x_1206
R4: 330; R_0603
R5: 10; R_1206
R6: 4.7k; R_array_4x_1206
SP1: SPEAKER; BUZZER_CCV
SW1: SPST; SWITCH_TACTILE_SPST
U1: SAMD21G18A-AUT; TQFP-48_7x7mm_Pitch0.5mm
U2: MIC5219-3.3BM5; SOT23_5
U3: MICRO-B_USB; USB-MICROB
U4: H3LIS331DL; TFLGA-16
U5: MPU-6050; QFN_24
U6: MS5607-02BA03; QFN8_5x3mm
U7: AT45DB641E; SO08_EIAJ
Y1: 32.768kHz; 32khz_crystal

Connections:
+3V3: C1.4, C2.1, C5.2, C7.1, C8.1, C9.1, C11.1, C13.1, C15.2, C16.1, C17.1, D1.1 (K), L1.1, R5.1, R6.1, R6.3, R6.5, SP1.2, U1.17 (VDDIO), U1.36 (VDDIO), U1.44 (VDDIN), U2.5 (VOUT), U4.1 (VDD_IO), U4.8 (CS), U4.14 (VDD), U4.15 (RESERVED), U5.8 (VLOGIC), U5.9 (AD0), U5.13 (VDD), U6.1 (VDD), U6.2 (PS), U6.4 (CSB), U6.5 (CSB), U7.6 (VCC)
+5V: D1.6 (A), U3.1 (VBUS)
+BATT: D1.4 (A), P1.2, P1.3, P2.2, P2.3, R2.1
/3RD: P1.4, Q3.3 (D), R2.7
/A1: R2.2, R3.1, U1.7 (PB08/EIC/AIN2/SCOM4PAD0/TC4)
/A2: R2.6, R3.5, U1.8 (PB09/EIC/AIN3/SCOM4PAD1/TC4)
/A3: R2.4, R3.3, U1.9 (PA04/EIC/REF/AIN4/SCOM0PAD0/TC0)
/A4: R2.8, R3.7, U1.10 (PA05/EIC/AIN5/SCOM0PAD1/TC0)
/APO: P1.1, Q1.3 (D), R2.5
/D2: Q1.1 (G), R1.3, U1.23 (PA14/XIN/EIC/SCOM2PAD2+/TC3)
/D3: Q4.1 (G), R1.5, U1.14 (PA09/I2C/EIC/AIN17/SCOM2PAD1+/TC0)
/D4: Q3.1 (G), R1.1, U1.13 (PA08/I2C/AIN16/SCOM2PAD0+/TC0)
/D6: R1.8, U1.29 (PA20/EIC/SCOM5PAD2+)
/D7: U1.30 (PA21/EIC/SCOM5PAD3+), U7.5 (WP)
/D8: U1.11 (PA06/EIC/AIN6/SCOM0PAD2/TC1), U7.3 (RESET)
/DATA+: U1.34 (PA25/EIC/SCOM3PAD3+/TC5), U3.3 (D+)
/DATA-: U1.33 (PA24/EIC/SCOM3PAD2+/TC5), U3.2 (D-)
/MAIN: P2.1, Q4.3 (D), R2.3
/MISO: U1.21 (PA12/I2C/EIC/SCOM2PAD0+/TC2), U7.8 (SO)
/MOSI: U1.19 (PB10/EIC/SCOM4PAD2/TC5), U7.1 (SI)
/RESET: C5.1, R4.2, U1.40 (RESETN)
/SCK: U1.20 (PB11/EIC/SCOM4PAD3/TC5), U7.2 (SCK)
/SCL: R6.2, U1.32 (PA23/I2C/EIC/SCOM5PAD1+/TC4), U4.4 (SCL/SPC), U5.23 (SCL), U6.8 (SCLK)
/SDA: R6.4, U1.31 (PA22/I2C/EIC/SCOM5PAD0+/TC4), U4.6 (SDA/SDI/SDO), U5.24 (SDA), U6.7 (SDI/SDA)
/SS: U1.27 (PA18/EIC/SCOM1PAD2+/TC3), U7.4 (CS)
GND: C1.1, C1.3, C2.2, C3.2, C3.4, C4.2, C6.2, C7.2, C8.2, C9.2, C10.2, C11.2, C12.2, C13.2, C14.1, C15.1, C16.2, C17.2, D2.1 (K), P2.4, Q1.2 (S), Q2.2 (S), Q3.2 (S), Q4.2 (S), R1.2, R1.4, R1.6, R3.2, R3.4, R3.6, R3.8, SW1.1, U1.5 (GNDANA), U1.18 (GND), U1.35 (GND), U1.42 (GND), U2.2 (GND), U3.5 (GND), U4.5 (GND), U4.7 (SDO/SDA0), U4.10 (RESERVED), U4.12 (GND), U4.13 (GND), U4.16 (GND), U5.1 (CLKIN), U5.11 (FSYNC), U5.18 (GND), U6.3 (GND), U7.7 (GND)
unnamed: C1.2, C4.1, L1.2, U1.6 (VDDANA)
unnamed: C3.1, U1.1 (PA00/XIN32/EIC/SCOM1PAD0/TC2), Y1.1
unnamed: C3.3, U1.2 (PA01/XOUT32/EIC/SCOM1PAD1/TC2), Y1.2
unnamed: C6.1, R5.2
unnamed: C10.1, U1.43 (VDDCORE)
unnamed: C12.1, U5.10 (REGOUT)
unnamed: C14.2, U5.20 (CPOUT)
unnamed: D1.2 (A), Q2.3 (D), SP1.1
unnamed: D1.3 (K), D1.5 (K), U2.1 (VIN), U2.3 (ENABLE)
unnamed: D2.2 (A), R6.6
unnamed: Q2.1 (G), R1.7
unnamed: R4.1, SW1.2

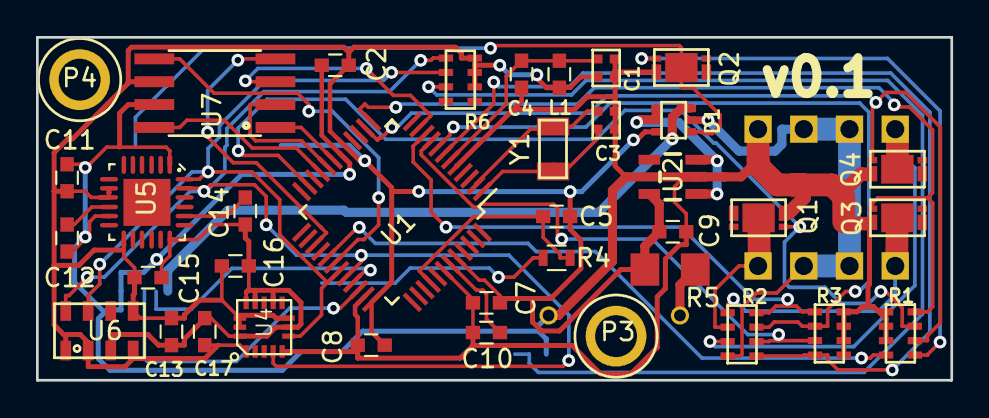
[picture p2: board altimeter.kicad_pcb from above]

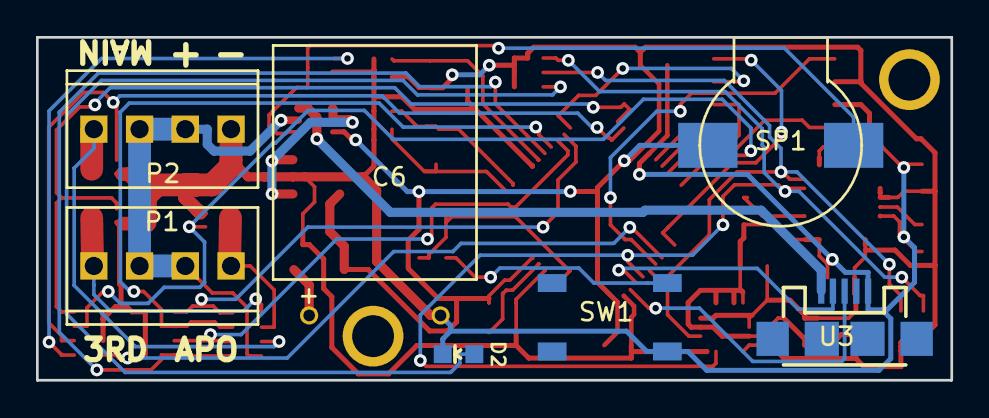
[picture p3: board altimeter.kicad_pcb from below]

Board: 2 copper layers, 50.8 x 19.0 mm, 44 parts (7 on the bottom side), 38 nets.
