rjopson/RoboAlt/interface/interface/core/cpp/src/entities/flight/motor.cpp

#include "Motor.h"

Motor::Motor(const std::string& name, const std::string& comments, const std::string& manufacturer,
    const double& diameter, const double& length, const std::vector<double>& delay, const double& mass_propellant, const double& mass_total,
    const std::vector<double>& data_time, const std::vector<double>& data_thrust)

    : Entity(name, comments),
      manufacturer_(manufacturer),
      diameter_(diameter),
      length_(length),
      delay_(delay),
      mass_propellant_(mass_propellant),
      mass_total_(mass_total),
      data_time_(data_time),
      data_thrust_(data_thrust) {

	//most data doesn't have a 0 time and thrust, so add (otherwise integration of thrust is low)
	if (data_time_[0] > 0.0) {
		data_time_.insert(data_time_.begin(), 0.0);
		data_thrust_.insert(data_thrust_.begin(), 0.0);
	}
}

Motor::Motor(const std::string& file_path) 
	: Entity("", "") {

	Parse(file_path);

	//most data doesn't have a 0 time and thrust, so add (otherwise integration of thrust is low)
	if (data_time_[0] > 0.0) {
		data_time_.insert(data_time_.begin(), 0.0);
		data_thrust_.insert(data_thrust_.begin(), 0.0);
	}
}

Motor::~Motor() {}

void Motor::SetManufacturer(const std::string& manufacturer) {
	manufacturer_ = manufacturer;
}

void Motor::SetDiameter(const double& diameter) {
	diameter_ = diameter;
}

void Motor::SetLength(const double& length) {
	length_ = length;
}

void Motor::SetDelay(const std::vector<double>& delay) {
	delay_ = delay;
}

void Motor::SetMassPropellant(const double& mass_propellant) {
	mass_propellant_ = mass_propellant;
}

void Motor::SetMassTotal(const double& mass_total) {
	mass_total_ = mass_total;
}

void Motor::SetDataTime(const std::vector<double>& time) {
	data_time_ = time;
}

void Motor::SetDataThrust(const std::vector<double>& thrust) {
	data_thrust_ = thrust;
}

std::string Motor::Manufacturer() const {
	return manufacturer_;
}

double Motor::Diameter() const {
	return diameter_;
}

double Motor::Length() const {
	return length_;
}

std::vector<double> Motor::Delay() const {
	return delay_;
}

double Motor::MassPropellant() const {
	return mass_propellant_;
}

double Motor::MassTotal() const {
	return mass_total_;
}

std::vector<double> Motor::DataTime() const {
	return data_time_;
}

std::vector<double> Motor::DataThrust() const {
	return data_thrust_;
}

double Motor::MassCase() const {
	return mass_total_ - mass_propellant_;
}

double Motor::Area() const {
	return kPi * std::pow(diameter_ / 2.0, 2);
}

double Motor::ImpulseTotal() const {
	return MathUtilities::Integrate(data_time_, data_thrust_).back();
}

std::vector<double> Motor::Impulse() const {
	return MathUtilities::Integrate(data_time_, data_thrust_);
}

double Motor::GetMass(const double& time) const {

	std::vector<double> impulse_function = Impulse();

	return mass_total_ - (mass_propellant_ / impulse_function.back())*MathUtilities::InterpolateLinear(data_time_, impulse_function, time);
}

double Motor::GetThrust(const double& time) const {

	return MathUtilities::InterpolateLinear(data_time_, data_thrust_, time);
}

void Motor::Print() const {

	//std::vector<double> time(1000);

	for (int i = 0; i != 2000; i++) {
		std::cout << (double)i / 1000.0 << ", " << GetThrust((double)i/1000.0) << std::endl;
	}	
}

bool Motor::CurrentlyThrusting(const double& time) const {
	
	bool thrusting = false;

	if (time <= data_time_.back()) {
		thrusting = true;
	}

	return thrusting;
}

void Motor::Parse(const std::string& file_path) {

	std::string data_string = Parse::GetDataString(file_path);
	std::istringstream iss(data_string);
	std::string line;
	std::string command;

	bool headerReached = false;
	while (std::getline(iss, line)) {

		//comment line
		if (line.at(0) == ';') {
			line.erase(line.begin());
			line.append("\n");
			AddToComments(line);
		}

		//header line
		else if (!headerReached) {

			std::vector<std::string> line_list = Parse::Split(line, ' ', false);
			SetName(line_list[0]);
			diameter_ = stod(line_list[1]) * 0.001;
			length_ = stod(line_list[2]) * 0.001;
			mass_propellant_ = stod(line_list[4]);
			mass_total_ = stod(line_list[5]);
			manufacturer_ = line_list[6];

			//Could have multiple delays
			for (auto element : Parse::Split(line_list[3], '-', false)) {
				delay_.push_back(stod(element));
			}
			headerReached = true;
		}

		//data line
		else {
			std::vector<std::string> line_list = Parse::Split(line, ' ', false);

			data_time_.push_back(stod(line_list[0]));
			data_thrust_.push_back(stod(line_list[1]));
		}
	}		
}
