rjopson/RoboAlt/firmware/src/process_data/manageSensorsAndControl.h

/*
 * manageSensorsAndControl.h
 *
 * This class ties together all sensor driver, engineering unit and filtering classes. 
 */

//#define TEST_SWITCH 1

#ifndef _MANAGE_SENSORS_AND_CONTROL_h
#define _MANAGE_SENSORS_AND_CONTROL_h

#if TEST_SWITCH == 1
#include "../../processDataTest/src/sensors.h"
#else 
#include "../driver/sensors.h"
#endif

#include <inttypes.h>
#include "dataStructures.h"
#include "sensorOffset.h"
#include "processData.h"
#include "kalman.h"
#include "flightLogic.h"

class manageSensorsAndControl {

public:
	manageSensorsAndControl();
	void initialize(const int32_t& altitudeMainDeployUser);
	void update();
	debugFlightData getDebugFlightData(const pyroContinuity& continuity);
	rawFlightData getRawFlightData(const pyroContinuity& continuity);

	//Data structures
	sensorData sensor_data;
	calibrationData calibration_data;
	engineeringData engineering_data;
	stateData state_data;

	//enum dataValidity {good, pressureBad, temperatureBad, };
	//bool validData; //true if data is clean, false if data has problem.

	//Classes to get data and reduce it
	sensors drivers;
	sensorOffset<int16_t> mpuOffset;
	sensorOffset<int16_t> h3lisOffset;
	sensorOffset<uint32_t> pressureOffset;
	sensorOffset<uint32_t> temperatureOffset;
	processData process_data;
	kalman filter;
	flightLogic logic;
};
#endif
