rjopson/RoboAlt/firmware/src/process_data/dataStructures.h

/*
 * dataStructure.h
 *
 * Wrapper for all data which is recorded to flash memory. Used in main altimeter loop to gather data, 
 * then pass to recording class
 */

#ifndef _DATA_STRUCTURES_h
#define _DATA_STRUCTURES_h

#include <inttypes.h>

struct debugFlightData {

	//4 byte 14 = 56 total
	//2 byte 18 = 36 total
	//1 byte 1 = 1 total

	//data to be used in flight logic and/or recorded
	uint32_t time; //(ms) //time used for filtering functions
	uint8_t flightStatus;
	int32_t altitude; //(mm) Kalman filtered altitude used in flight logic
	int32_t velocity; //(mm/s) Kalman filtered velocity used in flight logic
	int32_t acceleration; //(mm/s^2) Kalman filtered acceleration used in flight logic	
	int32_t altitudeBaro; //(mm) unfiltered barometric altitude
	int32_t accelAxial; //(mm/s^2) axial acceleration, chosen between MPU and H3LIS converted to engineering units, gravity subtracted
	uint32_t pressure; //(Pascal)
	int32_t temperature; //(100*degC)
	int16_t MPU_accelX, MPU_accelY, MPU_accelZ; //(16bit at 16g resolution) low g accelerometer measurements
	int16_t MPU_gyroX, MPU_gyroY, MPU_gyroZ; //(16bit at 2000deg/s resolution) gyro measurements
	int16_t H3LIS_accelY; //16bit at 200g seolution high g accelerometer
	uint32_t MS5607_pressure; //raw 4 byte pressure value from sensor
	uint32_t MS5607_temperature; //raw 4 byte temperature value from sensor		
	uint16_t voltageAnalog; //10 bit arduino
	uint16_t continuityApo;
	uint16_t continuityMain;
	uint16_t continuityThird;
};

struct userFlightData {

	//4 byte 14 = 56 total
	//2 byte 18 = 36 total
	//1 byte 1 = 1 total

	//data to be used in flight logic and/or recorded
	uint32_t time; //(ms) //time used for filtering functions
	uint8_t flightStatus;
	int32_t altitude; //(mm) Kalman filtered altitude used in flight logic
	int32_t velocity; //(mm/s) Kalman filtered velocity used in flight logic
	int32_t acceleration; //(mm/s^2) Kalman filtered acceleration used in flight logic	
	uint32_t pressure; //(Pascal)
	int32_t temperature; //(100*degC)
	int16_t MPU_accelX, MPU_accelY, MPU_accelZ; //(16bit at 16g resolution) low g accelerometer measurements
	int16_t MPU_gyroX, MPU_gyroY, MPU_gyroZ; //(16bit at 2000deg/s resolution) gyro measurements
	int16_t H3LIS_accelY; //16bit at 200g seolution high g accelerometer
	uint16_t voltage; //10 bit arduino
	uint16_t continuityApo;
	uint16_t continuityMain;
	uint16_t continuityThird;
};

struct rawFlightData {

	//data to be used in flight logic and/or recorded
	uint32_t time; //(ms) //time used for filtering functions
	int16_t MPU_accelX, MPU_accelY, MPU_accelZ; //(16bit at 16g resolution) low g accelerometer measurements
	int16_t MPU_gyroX, MPU_gyroY, MPU_gyroZ; //(16bit at 2000deg/s resolution) gyro measurements
	int16_t H3LIS_accelY; //16bit at 200g seolution high g accelerometer
	uint32_t MS5607_pressure; //raw 4 byte pressure value from sensor
	uint32_t MS5607_temperature; //raw 4 byte temperature value from sensor		
	uint16_t voltageAnalog; //10 bit arduino
	uint16_t continuityApo;
	uint16_t continuityMain;
	uint16_t continuityThird;
};

struct pyroContinuity {
	uint16_t apo;
	uint16_t main;
	uint16_t third;
};

struct calibrationData {

	//offsets
	int16_t mpuPad; //16 bit number, -16->16 g's
	int16_t h3lisPad; //16 bit number, -200->200 g's
	int32_t pressurePad; //32 bit number, raw
	int32_t temperaturePad; //32 bit number, raw
	int16_t voltageStartup; //16 bit number

	//Barometer coefficients
	uint16_t C[6];
};

struct sensorData {

	uint32_t time; //(ms) //time used for filtering functions
	int16_t accelX, accelY, accelZ; //(16bit at 16g resolution) low g accelerometer measurements
	int16_t gyroX, gyroY, gyroZ; //(16bit at 2000deg/s resolution) gyro measurements
	int16_t accelY_highG; //16bit at 200g seolution high g accelerometer
	uint32_t pressure; //raw 4 byte pressure value from sensor
	uint32_t temperature; //raw 4 byte temperature value from sensor		
	uint16_t voltageBattery; //10 bit arduino
};
struct engineeringData {

	uint32_t time; //(ms) //time used for filtering functions
	int32_t altitudeBaro; //(mm) unfiltered barometric altitude
	int32_t accelAxial; //(mm/s^2) axial acceleration, chosen between MPU and H3LIS converted to engineering units, gravity subtracted
	uint32_t pressure; //(Pascal)
	int32_t temperature; //(100*degC)
	int16_t voltageBattery; //voltage in mV
	int32_t test;
};

struct stateData {

	int32_t altitude; //(mm) Kalman filtered altitude used in flight logic
	int32_t velocity; //(mm/s) Kalman filtered velocity used in flight logic
	int32_t acceleration; //(mm/s^2) Kalman filtered acceleration used in flight logic	
};

struct userSettings_benchTest {
	
	bool settingsInFlash;
	int32_t altitudeMainDeploy;
	uint8_t apoFlightEvent;
	uint8_t mainFlightEvent;
	uint8_t thirdFlightEvent;
	uint32_t apoTimeDelay;
	uint32_t mainTimeDelay;
	uint32_t thirdTimeDelay;
	uint8_t buzzerSwitch;
};

#endif
