rjopson/RoboAlt/interface/interface/core/cpp/python_binding/binding/py_part.cpp

#include <pybind11/pybind11.h>
#include <pybind11/pytypes.h>

#include "part.h"

namespace py = pybind11;
using namespace pybind11::literals;

py::dict AttributesEntity(Entity* entity);
py::dict AttributesPart(Part* part) {
    return py::dict(**AttributesEntity(part),
        "type"_a = part->Type(),
        "material"_a = part->AssignedMaterial()->Name(),
        "mass_override"_a = part->OverrideMass(),
        "mass_override_switch"_a = part->OverrideMassSwitch(),
        "cg_override"_a = part->OverrideCg(),
        "cg_override_switch"_a = part->OverrideCgSwitch());
}

class PyPart : public Part {
public:
    using Part::Part; // Inherit constructors
    double VolumeMaterial() const { PYBIND11_OVERLOAD_PURE(double, Part, VolumeMaterial,); }
};

void init_part(py::module& m) {

    py::enum_<PartType>(m, "PartType")
        .value("BULKHEAD", PartType::BULKHEAD)
        .value("FINS", PartType::FINS)
        .value("NOSECONE", PartType::NOSECONE)
        .value("PARACHUTE", PartType::PARACHUTE)
        .value("POINT_MASS", PartType::POINT_MASS)
        .value("TUBE_BODY", PartType::TUBE_BODY)
        .value("TUBE_INNER", PartType::TUBE_INNER);

    py::class_<Part, PyPart, Entity>(m, "Part", py::multiple_inheritance())
        .def(py::init<PartType, const std::string&, const std::string&, Material*, bool, const double&, bool, const double&>())
        .def_property("material", &Part::AssignedMaterial, &Part::SetMaterial, py::return_value_policy::reference_internal)
        .def_property("mass_override", &Part::OverrideMass, &Part::SetOverrideMass)
        .def_property("mass_override_switch", &Part::OverrideMassSwitch, &Part::SetOverrideMassSwitch)
        .def_property("cg_override", &Part::OverrideCg, &Part::SetOverrideCg)
        .def_property("cg_override_switch", &Part::OverrideCgSwitch, &Part::SetOverrideCgSwitch)
        .def_property_readonly("type", &Part::Type)
        .def_property_readonly("mass", &Part::Mass)
        .def("attributes", &AttributesPart);        
}   
    
