rjopson/RoboAlt/interface/interface/core/cpp/src/entities/design/part_parachute.cpp

#include "part_parachute.h"

Parachute::Parachute(const std::string& name, const std::string& comments, Material* material,
    const double& diameter, const double& thickness,
    bool mass_override_switch, const double& mass_override, bool cg_override_switch, const double& cg_override) 
    
    : Part(PartType::PARACHUTE, name, comments, material, mass_override_switch, mass_override, cg_override_switch, cg_override),
      thickness_(thickness),
      diameter_(diameter) {

}

Parachute::~Parachute() {}

void Parachute::SetThickness(const double& thickness) {
    thickness_ = thickness;
}

void Parachute::SetDiameter(const double& diameter) {
    diameter_ = diameter;
}

void Parachute::SetArea(const double& area) {
    diameter_ = 2 * std::sqrt(area / kPi);
}

double Parachute::Thickness() const {
    return thickness_;
}

double Parachute::Diameter() const {
    return diameter_;
}

double Parachute::Area() const {
    return kPi * std::pow(diameter_ / 2.0, 2.0);
}

double Parachute::DragCoefficient() const {
    return Aerodynamics::DragCoefficientParachute();
}

double Parachute::VolumeMaterial() const {
    return Area()*thickness_;
}

Drag Parachute::DragModel() const {

    std::vector<double> mach{ 0.0, 0.8 };
    std::vector<double> cd{ DragCoefficient(), DragCoefficient() };

    Drag drag("Internal Model", "", true, DragType::PARACHUTE, "", Area(),
        mach, cd, mach, cd);

    return drag;
}
