rjopson/RoboAlt/interface/interface/core/cpp/src/entities/design/part_parachute.h

#ifndef _PARACHUTE_H
#define _PARACHUTE_H

#include "drag.h"
#include "part.h"

class Parachute : public Part {
  public:
    Parachute(const std::string& name, const std::string& comments, Material* material,
        const double& diameter, const double& thickness,
        bool mass_override_switch, const double& mass_override, bool cg_override_switch, const double& cg_override);
    ~Parachute();

    //Values
    void SetThickness(const double& thickness);
    void SetDiameter(const double& diameter);
    void SetArea(const double& area);

    //Datanames
    double Thickness() const;
    double Diameter() const;    
    double Area() const;

    //Core functions
    Drag DragModel() const;
    double DragCoefficient() const;
    double VolumeMaterial() const;      

  private:
    double thickness_;
    double diameter_;
};
#endif 
