rjopson/RoboAlt/firmware/src/drivers/buzzer.h

/*
 * buzzer.h
 *
 * Controls buzzer output
 */

#ifndef _BUZZER_h
#define _BUZZER_h

#include "Arduino.h"
#include "pins.h"

//Digital output pin
#define BUZZER_DIGITAL_PIN				PIN_BEEPER_DIGITAL_PIN

//Timing for beeps
#define BUZZER_TIME_ON_START_UP			250 //(ms) 
#define BUZZER_TIME_ON_DATA				200 //(ms) 
#define BUZZER_TIME_ON_FLIGHT_READY		150 //(ms) 
#define BUZZER_TIME_OFF_DATA			500 //(ms) 
#define BUZZER_TIME_OFF_BETWEEN_DATA	1000 //(ms)
#define BUZZER_TIME_OFF_FLIGHT_READY	2000 //(ms)
#define BUZZER_TIME_ON_VALID			150 //(ms)
#define BUZZER_TIME_ON_INVALID			5000 //(ms)

//Frequencies
#define BUZZER_FREQUENCY				2500 //(hz)
#define BUZZER_FREQUENCY_CONTINUITY		2700 //(hz)
#define BUZZER_FREQUENCY_NO_CONTINUITY	2200 //(hz)

class buzzer {
public:
	buzzer(const bool& buzzerSwitchIn);
	bool buzzerSwitch; //1 is buzzer output, 0 turns buzzer off

	void toneStartup();
	void preFlightChecks(const bool& dataValid, const uint16_t& voltageIn, const bool& continuityApo, const bool& continuityMain, const bool& continuityThird);
	bool flightReady(const bool& dataValidity, const uint32_t& timeIn);
	void onOffSwitch(bool setSwitch);

//private:
	//Functions which set frequency and duration of tone 
	void toneDataValid();
	void toneDataInvalid();
	void toneVoltage();
	void toneCheckContinuity(const uint16_t& continuityIn);
	void toneFlightReady();
	void toneOn(const uint32_t& frequency, const uint32_t& duration);

	//Start up functions used for preFlightChecks
	void dataValidity(const bool& dataValid);
	void voltageOutput(const uint16_t& voltageIn);
	void continuityOutput(const bool& continuityApo, const bool& continuityMain, const bool& continuityThird);

	uint32_t timePrevious;
};
#endif
