rjopson/RoboAlt/firmware/src/process_data/voltage.cpp

/*
 * voltage.h
 *
 * Convert analog read data to engineering units
 *
 */

#include "voltage.h"

/* Default constructor
 */
voltage::voltage() {

}

/* Convert analog read of battery voltage to engineering units - mV
 *
 */
int16_t voltage::battery(const int16_t& analogReadingIn) {

	int32_t reading = (int32_t)analogReadingIn;
	return ((int32_t)(VOLTAGE_BATTERY_DIVIDER*VOLTAGE_ATMEGA*reading)) >> 10;
}
