rjopson/RoboAlt/(commit log)

2018-10-18 added I2C, MS5607 classes
2018-10-18 transferred full I2C library over
2018-10-18 Complete MS5607 library to pull raw pressure, temp data
2018-10-18 Add MPU6050 class (16 accelerometer/gyro)
2018-10-18 add H3LIS331DL 200 g accelerometer
2018-10-19 Implement IMU class
2018-10-20 added IMU unit tests
2018-10-20 moved sensor classes to driver folder
2018-10-21 added AT45DB641 driver and pins.h
2018-10-25 added flight logic, cleaned up errors with includes in pyro
    [embedded.ino, flightLogic.cpp, flightLogic.h, pyro.cpp, pyro.h]
2018-10-25 add flightRecord class to track data to be recorded
2018-11-23 Kalman filter added
2018-11-25 processData class added to manage sensor conversion to engineering units, data filtering
2018-11-25 correct I2C read to replace timeout functionality. Not needed because Wire.requestFrom takes care of this.
    [I2C.cpp, I2C.h]
2018-11-25 begin main sensorAndControl for all sensor drivers and data reduction
2018-12-15 test data added, dataIO read function work
    [L3_shakedown.csv]
2018-12-16 dataIO read/write functionality implemented. Folder of flight test data added
    [processData_output.csv]
2018-12-16 convert state data to mm, Kalman class debugged
    [L3_shakedown.csv, processData_output.csv]
2019-02-11 Added new KiCad project with .sch and _pcb files
    [altimeter.kicad_pcb, altimeter.sch, processData_output.csv]
2019-02-11 Update hardware file structure
    [altimeter.kicad_pcb, altimeter.sch]
2019-02-11 Added KiCad schematic component library
2019-02-11 add KiCad footprints
2019-02-11 Major components added to schematic
2019-02-11 Reorganize Hardware folder
    [altimeter.kicad_pcb, altimeter.sch]
2019-02-18 Pyro output, regulator and buzzer schematics created
    [altimeter.sch]
2019-02-25 Schematic - sensors connected
    [altimeter.sch]
2019-02-25 combine resistors into arrays
    [altimeter.sch]
2019-02-25 Component and footprint association
    [altimeter.sch]
2019-02-25 Create pcb with all components
    [altimeter.sch]
2019-04-08 board connected
    [altimeter.dsn, altimeter.kicad_pcb, altimeter.sch, altimeter_power.kicad_pcb]
2019-04-09 flightDataStorage implemented
    [processData_output.csv]
2019-04-10 buzzer startup functionality, pyro class cleanup
    [buzzer.cpp, buzzer.h, dataStructures.h, embedded.ino, manageSensorsAndControl.h, pyro.cpp, pyro.h]
2019-06-15 Board v0.1 ordered
    [altimeter.kicad_pcb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]
2019-06-17 add python plotting script for processData
    [L3_shakedown.csv, processData_output.csv]
2019-09-04 Sod Blaster Tri Cities 2019 - clean code, hardware
    [3DPME_24mm_E9-8_TriCities_9-2019.csv, 3DPME_29mm_H128_TriCities_9-2019.csv, 3DPME_29mm_H180_TriCities_9-2019.csv, BOM.xlsx, altimeter.kicad_pcb, processData_output.csv, rawData_formatTest.csv]
2019-09-21 Interface program development
    [3DPME_29mm_H128_TriCities_9-2019.csv, 3DPME_29mm_H180_TriCities_9-2019.csv]
2019-11-22 pull simulation data from engine
    [3DPME_24mm_E9-8_TriCities_9-2019.csv, 3DPME_24mm_E9-8_TriCities_9-2019_v2.csv, 3DPME_29mm_H128_TriCities_9-2019.csv, 3DPME_29mm_H128_TriCities_9-2019_v2.csv, 3DPME_29mm_H180_TriCities_9-2019.csv, 3DPME_29mm_H180_TriCities_9-2019_v2.csv, L3_shakedown.csv, L3_shakedown_v2.csv]
2020-02-02 Initial cpp interface core implementation
    [Configuration.h]
2020-02-08 before testing std::function
    [Configuration.h]
2020-02-14 work on supporting stages
    [Configuration.h]
2020-02-27 SimulationStage concept
    [Configuration.h]
2020-03-06 refactor to place drag calcs in stage
    [Configuration.h]
2020-03-13 before style cleanup, changes to be usable with Cython
    [Configuration.h]
2020-03-14 after style cleanup
    [Configuration.h, configuration.h]
2020-03-20 for AZ
    [configuration.h]
2020-04-01 hide pointer vectors in entity classes
    [configuration.h]
2020-04-04 entity inheritance test
    [configuration.h]
2020-04-05 after entity base class conversion
    [configuration.h]
2020-04-07 before cleanup of user events, sim stages in simulation
    [configuration.h]
2020-04-08 after simulation cleanup
    [configuration.h]
2020-04-11 before inheritance for part in python
    [configuration.h]
2020-04-12 solution structure cleanup
    [3DPME_24mm_E9-8_TriCities_9-2019.csv, 3DPME_24mm_E9-8_TriCities_9-2019_v2.csv, 3DPME_29mm_H128_TriCities_9-2019.csv, 3DPME_29mm_H128_TriCities_9-2019_v2.csv, 3DPME_29mm_H180_TriCities_9-2019.csv, 3DPME_29mm_H180_TriCities_9-2019_v2.csv, L3_shakedown.csv, L3_shakedown_v2.csv]
2020-04-12 directory cleanup
    [BOM.xlsx, altimeter.dsn, altimeter.kicad_pcb, altimeter.sch, altimeter_power.kicad_pcb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]
2020-04-13 clearing directory
    [3DPME_24mm_E9-8_TriCities_9-2019.csv, 3DPME_24mm_E9-8_TriCities_9-2019_v2.csv, 3DPME_29mm_H128_TriCities_9-2019.csv, 3DPME_29mm_H128_TriCities_9-2019_v2.csv, 3DPME_29mm_H180_TriCities_9-2019.csv, 3DPME_29mm_H180_TriCities_9-2019_v2.csv, BOM.xlsx, L3_shakedown.csv]
2020-04-13 project cleanup
    [configuration.h]
2020-04-29 before removal of sim stage
    [3DPME_29mm_H128_TriCities_9-2019_v2.csv, configuration.h]
2020-04-29 after removal of experimental-stage and simulation_stage
2020-05-10 conversion to pybind11 for core python code
    [configuration.h]
2020-05-12 corrected default motor name
    [entity_manager.cpp, hdf5_database.py]
